maslohaslo1234-spec/BalanceCube/README.md

# BalanceCube

Zrzut ekranu 2026-11-08 210207

---

## What is this?

It's a 3D printed cube that can (hopefully) balance on one corner or one edge. It uses flywheels, brushless motors, an ESP32, and an IMU to balance the cube.

### Features:
- **Balancing** - using three brushless motors and flywheels.
- **Custom PCB** - Designed in KiCad.
- **Lightweight Frame** - It can almost fly (:
- **Firmware** - It works (optional).

---

## How it works?

It works by spinning the reaction wheels in the opposite way that the cube is tilting. The reaction wheels are spun by brushless motors, and the motors are controlled by the ESP32. The ESP32 gets data from the MPU6050 IMU and processes this data using my code, and then it sends control signals to the motors. This way the cube always stays upright (hopefully).

---

## Why am I making this?

I stumbled upon the Fallen program and started thinking if I would be able to join. I remembered a recent YT video from [The Tinkering Techie channel](https://www.youtube.com/@TheTinkeringTechie) about a balancing cube and thought that it was really cool and that I can make something similar in Fallen.

---

## Mechanical Design

The mechanical parts are modeled in Onshape.

Public Onshape Project Link: [Onshape BalanceCube Document](https://cad.onshape.com/documents/2c01e583674b5bc36f37b82b/w/a163e07f377434656225f53e/e/8aebbe53c625277084c7079e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)

In the repo it can be found here: [CAD](cad/)







---

## Electronics

The PCB is designed in KiCad.

In the repo it can be found here: [PCB](PCB/)

Zrzut ekranu 2026-11-02 201625





---

## Bill of Materials (BOM)

All parts, links, and prices can be found in [bom.csv](bom.csv).

---

## Inspirations & Credits

- [Rem-RC Self-Balancing-Cube](https://github.com/remrc/Self-Balancing-Cube)
- [ETH Zurich Cubli](https://idsc.ethz.ch/research-dandrea/research-projects/archive/cubli.html)
- [The Tinkering Techie](https://www.youtube.com/@TheTinkeringTechie)

---

## License

This project is open-source and licensed under the [MIT License](LICENSE).
