maslohaslo1234-spec/BalanceCube/cad/step/BalanceCube_Assembly.step

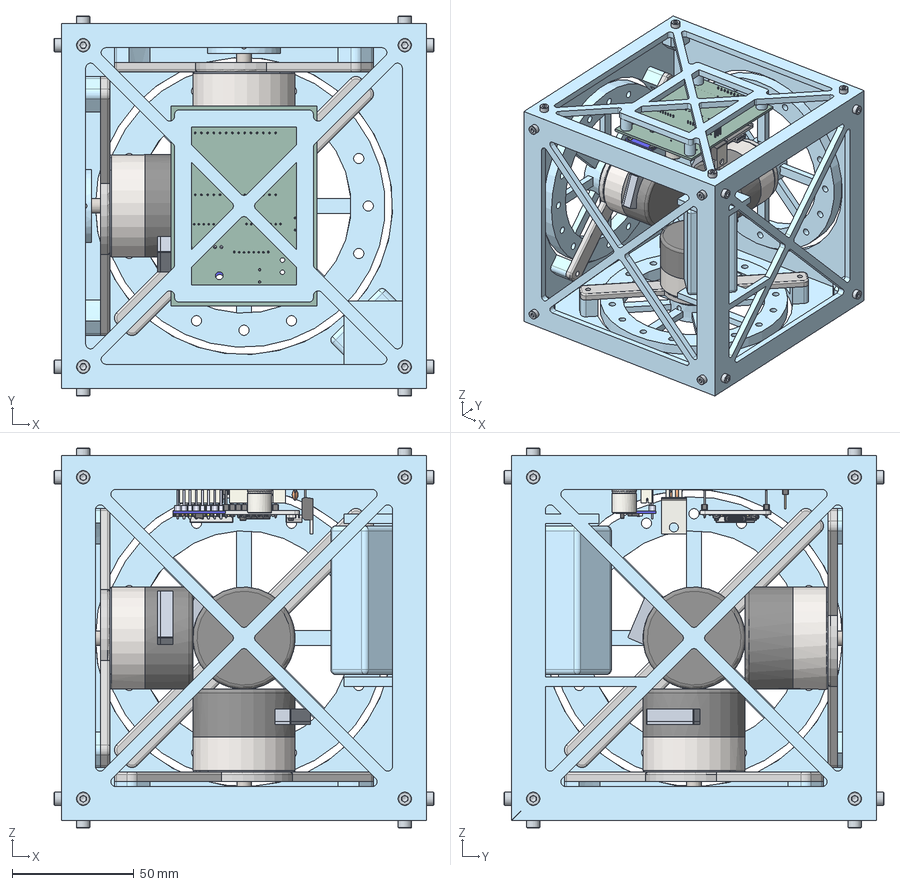
[picture p1: CAD file, 2026-11-09]
cad/step/BalanceCube_Assembly.step
156.0 x 156.0 x 156.0 mm
Hex socket head cap screw M3x0.50 x 8 x 24
motor__ DE 721 x 3
motor__ DE 463 x 3
motor__ DE 37 x 3
3s 650mAh
Corps130
Corps46
soudures:1__Corps19
Corps219
Corps74
soudures:1__Corps12
Corps95
soudures:1__Corps27
usb C:1__Corps16
Corps65
usb C:1__Corps13
Corps93
usb C:1__Corps44
Corps209
usb C:1__Corps27
Corps194
PIN:1__Corps16
usb C:1__Corps9
PIN:1__Corps18
PIN:1__Corps5
C_Disc_D50mm_W25mm_P500mm
Corps214
PinHeader_1x08_P254mm_Vertical
soudures:1__Corps2
Corps198
Corps45
soudures:1__Corps15
Corps49
usb C:1__Corps5
usb C:1__Corps3
Corps106
usb C:1__Corps32
Corps53
Corps38
usb C:1__Corps6
PIN:1__Corps20
usb C:1__Corps25
Corps224
Corps40
Corps189
soudures:1__Corps18
soudures:1__Corps23
Corps119
Corps246
Corps108
Corps57
Corps253
PIN:1__Corps11
Corps111
Corps59
Corps208
Corps78
PIN:1__Corps23
usb C:1__Corps24
Corps110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
