maslohaslo1234-spec/BalanceCube/cad/step/flywheel.step

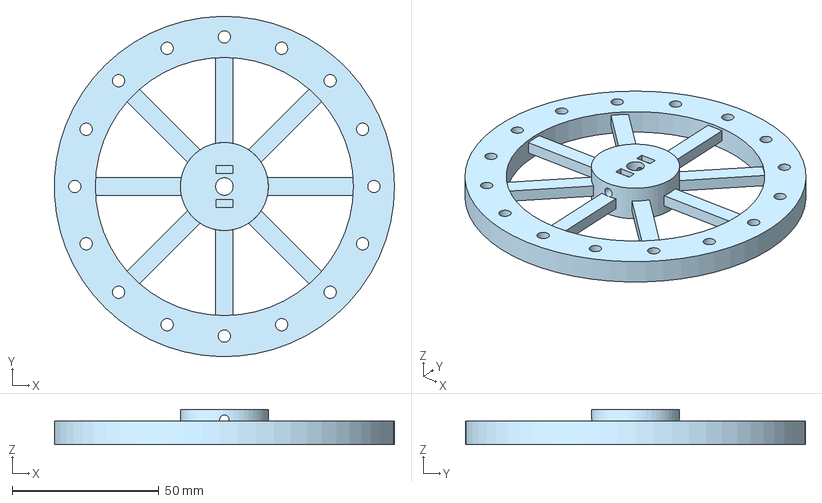
[picture p2: CAD file, 2026-11-10]
cad/step/flywheel.step
115.9 x 116.0 x 12.0 mm
