maslohaslo1234-spec/BalanceCube/cad/stl/PCB_wall_x1.stl

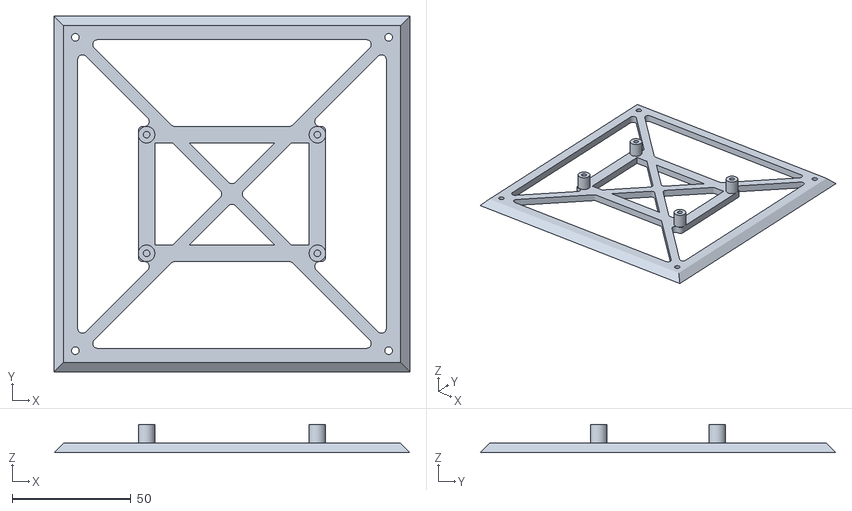
[picture p3: CAD file, 2026-11-09]
cad/stl/PCB_wall_x1.stl
150.0 x 150.0 x 12.0
