maslohaslo1234-spec/BalanceCube/cad/step/corner_bracket.step

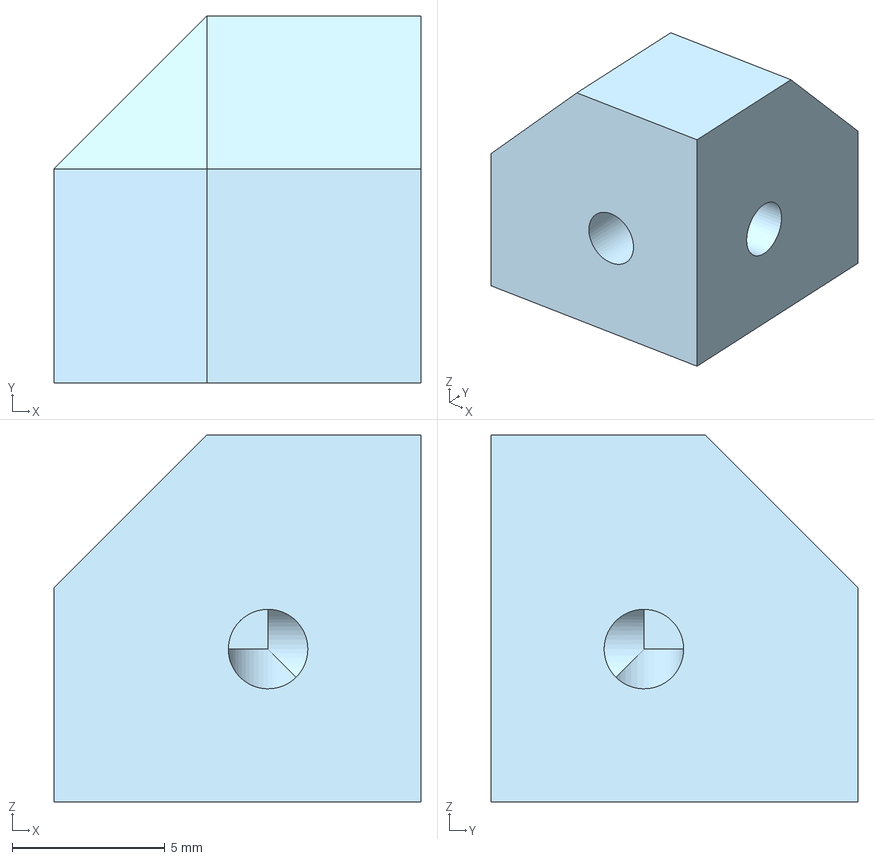
[picture p4: CAD file, 2026-11-10]
cad/step/corner_bracket.step
12.0 x 12.0 x 12.0 mm
