maslohaslo1234-spec/BalanceCube/cad/stl/closing_wall_x1.stl

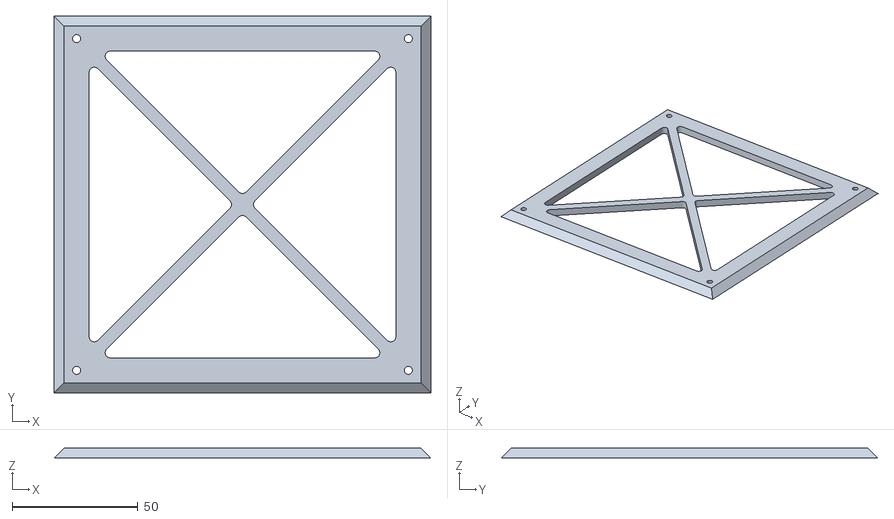
[picture p5: CAD file, 2026-11-09]
cad/stl/closing_wall_x1.stl
150.0 x 150.0 x 4.00
