maslohaslo1234-spec/BalanceCube/cad/stl/battery_wall_x1.stl

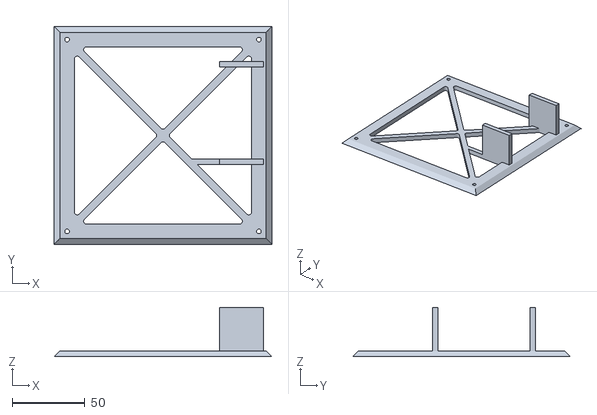
[picture p6: CAD file, 2026-11-09]
cad/stl/battery_wall_x1.stl
150.0 x 150.0 x 34.0
