maslohaslo1234-spec/BalanceCube/cad/step/motor_bridge.step

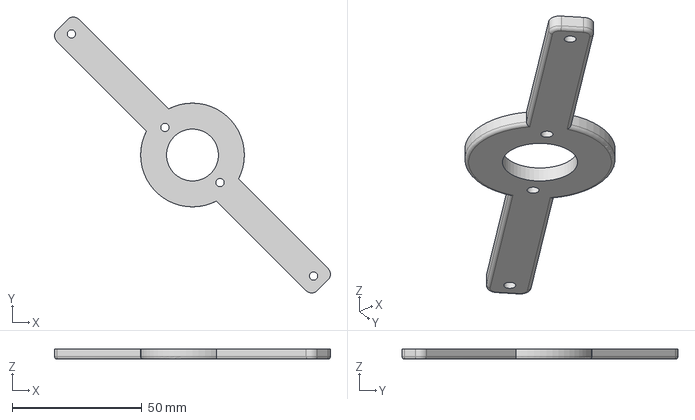
[picture p7: CAD file, 2026-11-10]
cad/step/motor_bridge.step
106.4 x 106.4 x 4.00 mm
