maslohaslo1234-spec/BalanceCube/cad/step/motor_wall.step

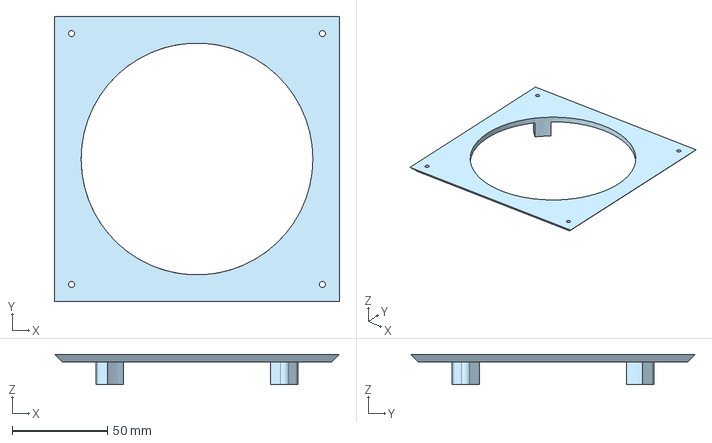
[picture p8: CAD file, 2026-11-10]
cad/step/motor_wall.step
150.0 x 150.0 x 16.0 mm
