maslohaslo1234-spec/BalanceCube/(list of files, cad)

Other CAD files:
cad/step/PCB_wall.step
cad/stl/motor_bridge_x3.stl
cad/stl/motor_wall_x3.stl
cad/step/battery_wall.step
cad/stl/corner_bracket_x8.stl
cad/step/closing_wall.step
cad/stl/Flywheel_x3.stl
