maslohaslo1234-spec/BalanceCube/PCB/BalanceCube.kicad_pcb

## KiCad design PCB/BalanceCube.kicad_pcb (2026-11-09)

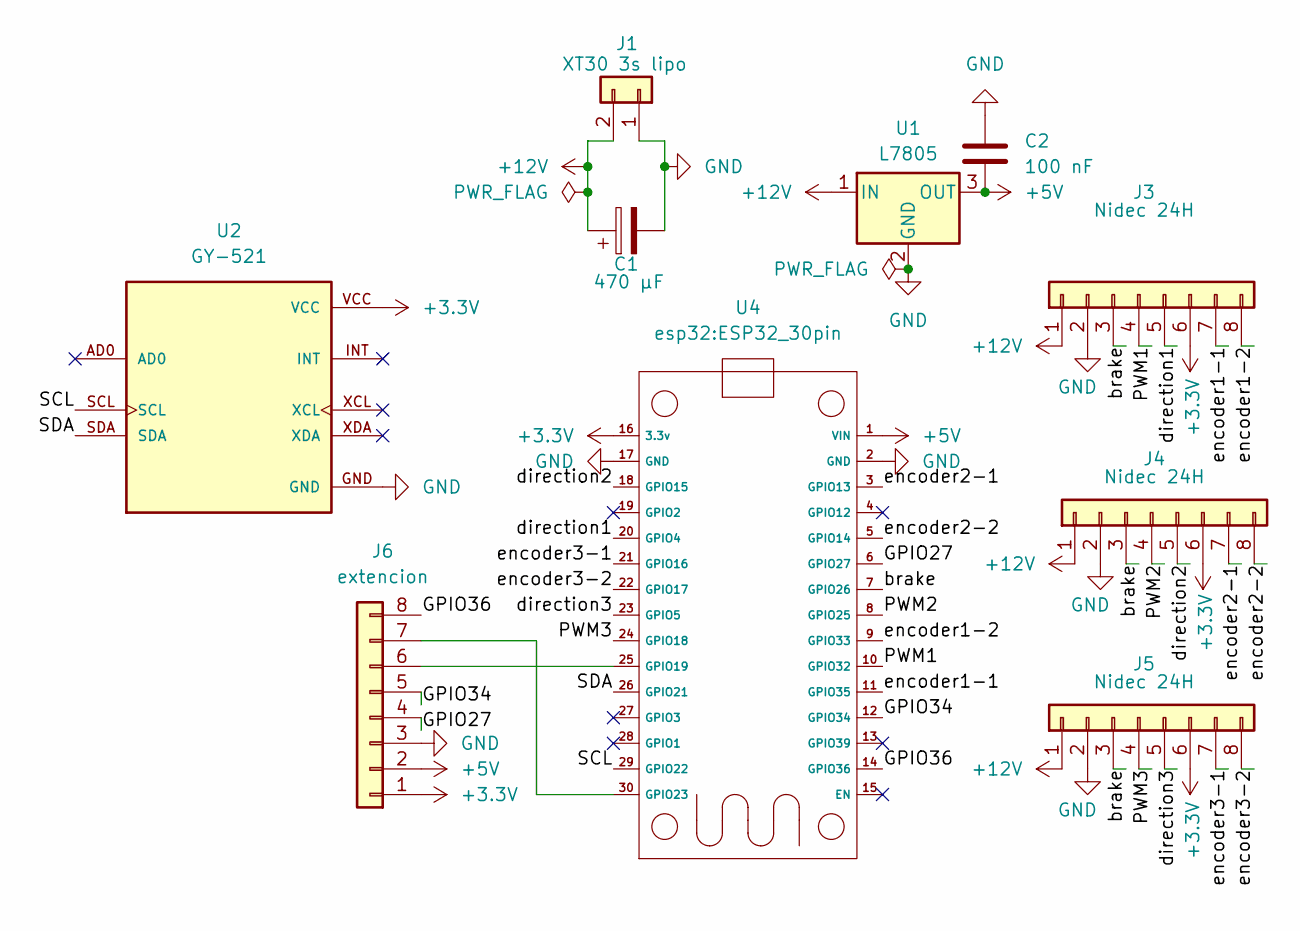
[picture p9: schematic BalanceCube.kicad_sch]

Parts:
C1: 470 µF; CP_Radial_D10.0mm_P5.00mm
C2: 100 nF; C_Disc_D5.0mm_W2.5mm_P5.00mm
J1: XT30 3s lipo; AMASS_XT30PW-M_1x02_P2.50mm_Horizontal
J3, J4, J5: Nidec 24H; JST_PH_B8B-PH-K_1x08_P2.00mm_Vertical
J6: extencion; PinHeader_1x08_P2.54mm_Vertical
U1: L7805; TO-220-3_Vertical
U2: GY-521; MODULE_GY-521; PARTREV NA
U4: ESP32_30pin

Connections:
+3.3V: J3.6, J4.6, J5.6, J6.1, U2.VCC, U4.16 (3.3v)
+5V: C2.2, J6.2, U1.3 (OUT), U4.1 (VIN)
+12V: C1.1, J1.2, J3.1, J4.1, J5.1, U1.1 (IN)
/GPIO27: J6.4, U4.6 (GPIO27)
/GPIO34: J6.5, U4.12 (GPIO34)
/GPIO36: J6.8, U4.14 (GPIO36)
/PWM1: J3.4, U4.10 (GPIO32)
/PWM2: J4.4, U4.8 (GPIO25)
/PWM3: J5.4, U4.24 (GPIO18)
/SCL: U2.SCL, U4.29 (GPIO22)
/SDA: U2.SDA, U4.26 (GPIO21)
/brake: J3.3, J4.3, J5.3, U4.7 (GPIO26)
/direction1: J3.5, U4.20 (GPIO4)
/direction2: J4.5, U4.18 (GPIO15)
/direction3: J5.5, U4.23 (GPIO5)
/encoder1-1: J3.7, U4.11 (GPIO35)
/encoder1-2: J3.8, U4.9 (GPIO33)
/encoder2-1: J4.7, U4.3 (GPIO13)
/encoder2-2: J4.8, U4.5 (GPIO14)
/encoder3-1: J5.7, U4.21 (GPIO16)
/encoder3-2: J5.8, U4.22 (GPIO17)
GND: C1.2, C2.1, J1.1, J3.2, J4.2, J5.2, J6.3, U1.2 (GND), U2.GND, U4.2 (GND), U4.17 (GND)
unnamed: J6.6, U4.25 (GPIO19)
unnamed: J6.7, U4.30 (GPIO23)

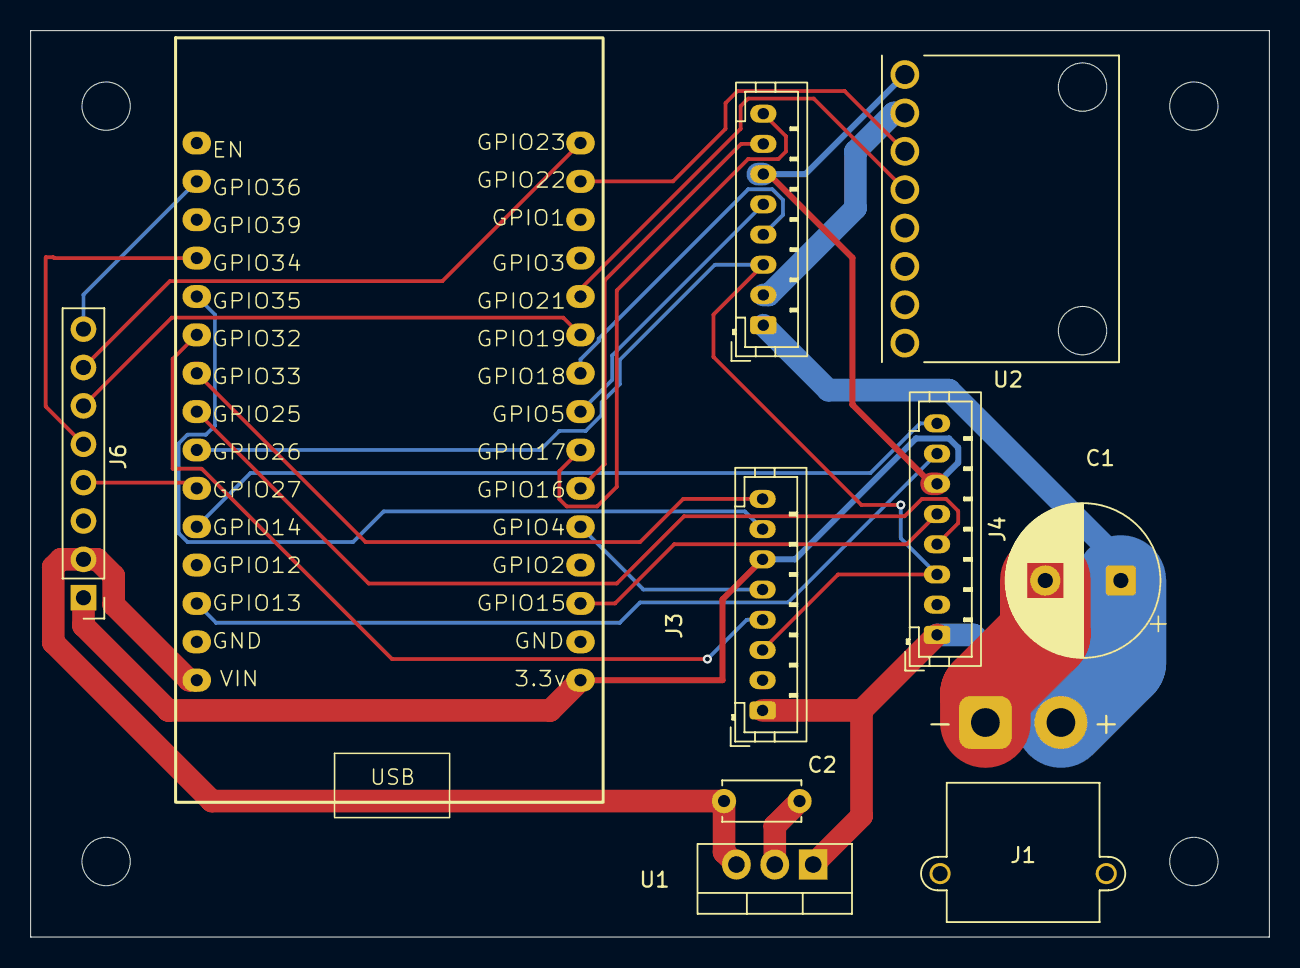
[picture p10: board BalanceCube.kicad_pcb from above]

Board: 2 copper layers, 82.0 x 60.0 mm, 10 parts (0 on the bottom side), 24 nets.
