maslohaslo1234-spec/BalanceCube/(commit log)

2026-11-10 Refine descriptions of truss frame and PCB-wall
    Updated feature descriptions for clarity and conciseness.
2026-11-10 Create bom.csv with itemized components
    Added bill of materials with item details, quantities, and prices.
    [bom.csv]
2026-11-10 Modify BOM with new product links and prices
    Updated product links and prices in the BOM.
    [bom.csv]
2026-11-10 Modify quantities and notes in bom.csv
    Updated quantities and notes for several items in the BOM.
    [bom.csv]
2026-11-10 Modify M4x16 bolts price and update total
    Updated the price of M4x16 bolts kit and adjusted the total.
    [bom.csv]
2026-11-10 Fix unit price for Custom 2-Layer PCB
    Updated unit price for Custom 2-Layer PCB from 2.00 to 0.40.
    [bom.csv]
2026-11-11 Refine terminology in README for motors and frame
    Updated terminology for clarity and consistency in the README.
2026-11-12 Delete cad/stl/motor_bridge_x3.stl.stl
    wrong name
    [motor_bridge_x3.stl.stl]
2026-11-12 Delete cad/stl/motor_wall_x3.stl.stl
    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
    [motor_wall_x3.stl.stl]
2026-11-12 Delete hardware directory
    name correction
    [BalanceCube.kicad_pcb, BalanceCube.kicad_sch]
